bhthoma2/77GHx_phased_array/layout/testbenches/simulations/fmcw_fft_spectrum.csv

freq_kHz | power_dB
0.000000000000000000e+00 | -1.090621895206825229e+02
9.998999774820033215e-01 | -1.150786784525959945e+02
1.999799954964006643e+00 | -1.671857838909060945e+02
2.999699932446010298e+00 | -1.729609599861555580e+02
3.999599909928013286e+00 | -1.557259817246414002e+02
4.999499887410016719e+00 | -1.606970284841859780e+02
5.999399864892020595e+00 | -1.563933010316140724e+02
6.999299842374023584e+00 | -1.581940688958517853e+02
7.999199819856026572e+00 | -1.579772593100962013e+02
8.999099797338031337e+00 | -1.547865157363306139e+02
9.998999774820033437e+00 | -1.534639720176898265e+02
1.099889975230203731e+01 | -1.518139555042989741e+02
1.199879972978404119e+01 | -1.493432436280089064e+02
1.299869970726604329e+01 | -1.481261765680644089e+02
1.399859968474804717e+01 | -1.450455039046750301e+02
1.499849966223004927e+01 | -1.433179995515134237e+02
1.599839963971205314e+01 | -1.409208785659695309e+02
1.699829961719405702e+01 | -1.384513721816443876e+02
1.799819959467606267e+01 | -1.350676107547158153e+02
1.899809957215806122e+01 | -1.320419547814693146e+02
1.999799954964006687e+01 | -1.283672178343013286e+02
2.099789952712206897e+01 | -1.239795349886419871e+02
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
