bhthoma2/77GHx_phased_array/layout/testbenches/simulations/vibrometer_spectrum.csv

freq_Hz | mine_displacement_um | ground_displacement_um
0.000000000000000000e+00 | 2.290995417833598502e+00 | 5.967242599954593156e-03
1.562500000000000000e+01 | 2.011276875167306688e+00 | 5.195269922505948990e-03
3.125000000000000000e+01 | 7.555092282637777545e-01 | 1.956425115981483016e-03
4.687500000000000000e+01 | 8.818032765825689623e-02 | 2.256138587524450729e-04
6.250000000000000000e+01 | 2.040893415404172392e-02 | 3.436512302175389005e-05
7.812500000000000000e+01 | 4.964686714766459834e-03 | 2.022881577656870960e-05
9.375000000000000000e+01 | 1.550301483289384880e-03 | 2.336107414771621820e-05
1.093750000000000000e+02 | 9.700698680088382098e-03 | 1.860979419314093665e-05
1.250000000000000000e+02 | 6.060755942978538618e-02 | 1.206326097360342285e-05
1.406250000000000000e+02 | 3.664197379278069655e-01 | 1.532811229838642000e-05
1.562500000000000000e+02 | 4.178634805061605673e-01 | 8.616809125811206193e-06
1.718750000000000000e+02 | 1.088389716323305279e-01 | 1.098252997681459136e-05
1.875000000000000000e+02 | 1.221630721593647793e-02 | 1.028817932801487940e-05
2.031250000000000000e+02 | 3.546585447817903955e-03 | 8.686981510296186307e-06
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
