bhthoma2/77GHx_phased_array/layout/full_chip_layout.png

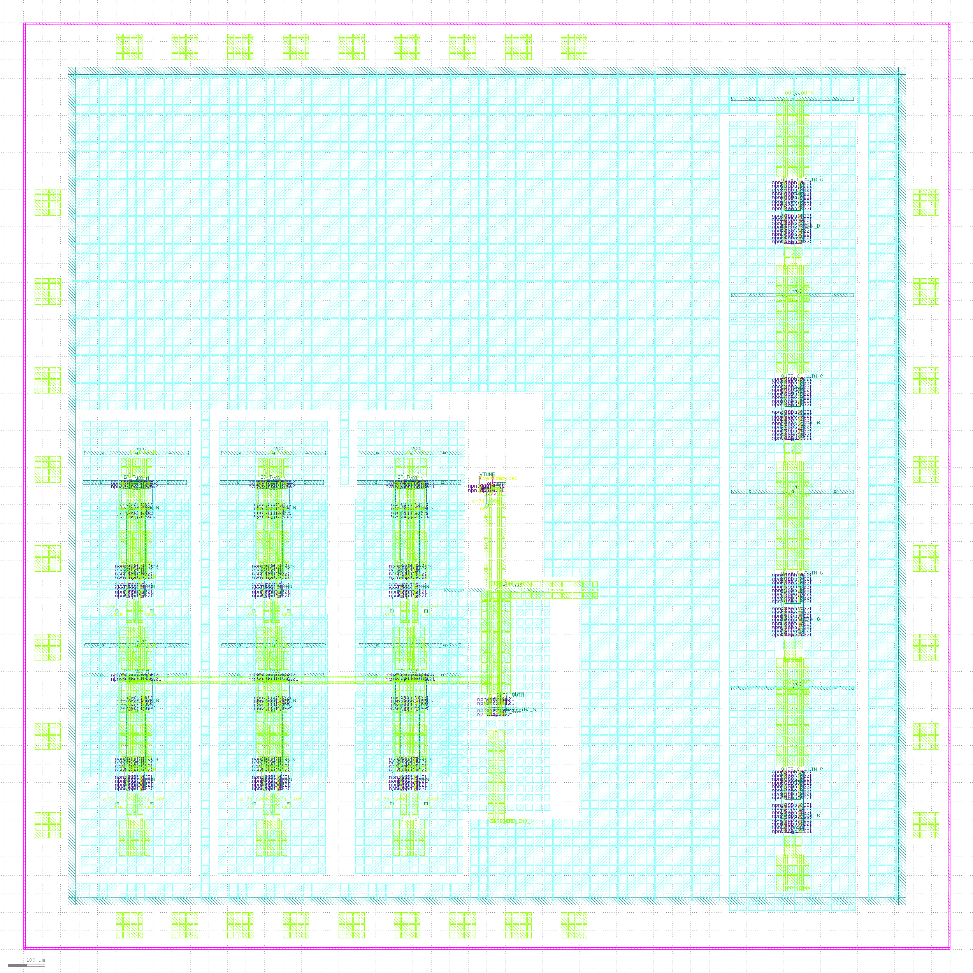
layout/full_chip_layout.png
