bhthoma2/77GHx_phased_array/sim/phase_shifter_results.txt

 7.00000000e+10  7.00000000e+10  0.00000000e+00  7.00000000e+10  1.26916296e-01  5.17553875e-02  7.00000000e+10  2.00000000e-01  0.00000000e+00  7.00000000e+10  6.34581480e-02  2.58776938e-02  7.00000000e+10 -6.34581480e-02 -2.58776938e-02  7.00000000e+10  1.00000000e-01  0.00000000e+00  7.00000000e+10 -1.00000000e-01  0.00000000e+00 
 7.01515152e+10  7.01515152e+10  0.00000000e+00  7.01515152e+10  1.26999486e-01  5.16685443e-02  7.01515152e+10  2.00000000e-01  0.00000000e+00  7.01515152e+10  6.34997432e-02  2.58342722e-02  7.01515152e+10 -6.34997432e-02 -2.58342722e-02  7.01515152e+10  1.00000000e-01  0.00000000e+00  7.01515152e+10 -1.00000000e-01  0.00000000e+00 
 7.03030303e+10  7.03030303e+10  0.00000000e+00  7.03030303e+10  1.27082234e-01  5.15818648e-02  7.03030303e+10  2.00000000e-01  0.00000000e+00  7.03030303e+10  6.35411172e-02  2.57909324e-02  7.03030303e+10 -6.35411172e-02 -2.57909324e-02  7.03030303e+10  1.00000000e-01  0.00000000e+00  7.03030303e+10 -1.00000000e-01  0.00000000e+00 
 7.04545455e+10  7.04545455e+10  0.00000000e+00  7.04545455e+10  1.27164543e-01  5.14953492e-02  7.04545455e+10  2.00000000e-01  0.00000000e+00  7.04545455e+10  6.35822713e-02  2.57476746e-02  7.04545455e+10 -6.35822713e-02 -2.57476746e-02  7.04545455e+10  1.00000000e-01  0.00000000e+00  7.04545455e+10 -1.00000000e-01  0.00000000e+00 
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
