bhthoma2/77GHx_phased_array/sim/radar_full_results.txt

 0.00000000e+00  2.79326692e+00  0.00000000e+00  2.78764656e+00  0.00000000e+00  2.05281450e+00 
 1.00000000e-12  2.79323010e+00  1.00000000e-12  2.78754390e+00  1.00000000e-12  2.05280015e+00 
 2.00000000e-12  2.79322576e+00  2.00000000e-12  2.78752316e+00  2.00000000e-12  2.05283011e+00 
 4.00000000e-12  2.79323541e+00  4.00000000e-12  2.78752886e+00  4.00000000e-12  2.05286235e+00 
 8.00000000e-12  2.79325845e+00  8.00000000e-12  2.78756814e+00  8.00000000e-12  2.05283804e+00 
 1.60000000e-11  2.79327409e+00  1.60000000e-11  2.78762384e+00  1.60000000e-11  2.05275629e+00 
 3.20000000e-11  2.79326382e+00  3.20000000e-11  2.78767782e+00  3.20000000e-11  2.05249357e+00 
 6.40000000e-11  2.79323356e+00  6.40000000e-11  2.78775361e+00  6.40000000e-11  2.05117444e+00 
 1.28000000e-10  2.79319006e+00  1.28000000e-10  2.78800207e+00  1.28000000e-10  2.04595673e+00 
 2.28000000e-10  2.79312429e+00  2.28000000e-10  2.78857185e+00  2.28000000e-10  2.03418369e+00 
 3.28000000e-10  2.79305505e+00  3.28000000e-10  2.78923513e+00  3.28000000e-10  2.02083150e+00 
 4.28000000e-10  2.79298396e+00  4.28000000e-10  2.78991575e+00  4.28000000e-10  2.00763906e+00 
 5.28000000e-10  2.79291164e+00  5.28000000e-10  2.79057853e+00  5.28000000e-10  1.99540210e+00 
 6.28000000e-10  2.79283819e+00  6.28000000e-10  2.79121013e+00  6.28000000e-10  1.98437811e+00 
 7.28000000e-10  2.79276368e+00  7.28000000e-10  2.79180729e+00  7.28000000e-10  1.97458071e+00 
 8.28000000e-10  2.79268818e+00  8.28000000e-10  2.79237063e+00  8.28000000e-10  1.96593629e+00 
 9.28000000e-10  2.79261173e+00  9.28000000e-10  2.79290185e+00  9.28000000e-10  1.95835161e+00 
 1.02800000e-09  2.79253438e+00  1.02800000e-09  2.79340274e+00  1.02800000e-09  1.95173707e+00 
 1.12800000e-09  2.79245620e+00  1.12800000e-09  2.79387492e+00  1.12800000e-09  1.94601186e+00 
 1.22800000e-09  2.79237723e+00  1.22800000e-09  2.79431986e+00  1.22800000e-09  1.94110331e+00 
 1.32800000e-09  2.79229751e+00  1.32800000e-09  2.79473892e+00  1.32800000e-09  1.93694527e+00 
 1.42800000e-09  2.79221710e+00  1.42800000e-09  2.79513339e+00  1.42800000e-09  1.93347677e+00 
 1.52800000e-09  2.79213603e+00  1.52800000e-09  2.79550450e+00  1.52800000e-09  1.93064125e+00 
 1.62800000e-09  2.79205435e+00  1.62800000e-09  2.79585344e+00  1.62800000e-09  1.92838608e+00 
 1.72800000e-09  2.79197210e+00  1.72800000e-09  2.79618135e+00  1.72800000e-09  1.92666221e+00 
 1.82800000e-09  2.79188932e+00  1.82800000e-09  2.79648933e+00  1.82800000e-09  1.92542398e+00 
 1.92800000e-09  2.79180605e+00  1.92800000e-09  2.79677844e+00  1.92800000e-09  1.92462887e+00 
 2.02800000e-09  2.79172231e+00  2.02800000e-09  2.79704968e+00  2.02800000e-09  1.92423737e+00 
 2.12800000e-09  2.79163815e+00  2.12800000e-09  2.79730402e+00  2.12800000e-09  1.92421272e+00 
 2.22800000e-09  2.79155359e+00  2.22800000e-09  2.79754236e+00  2.22800000e-09  1.92452082e+00 
 2.32800000e-09  2.79146867e+00  2.32800000e-09  2.79776558e+00  2.32800000e-09  1.92512998e+00 
 2.42800000e-09  2.79138341e+00  2.42800000e-09  2.79797451e+00  2.42800000e-09  1.92601081e+00 
 2.52800000e-09  2.79129784e+00  2.52800000e-09  2.79816994e+00  2.52800000e-09  1.92713607e+00 
 2.62800000e-09  2.79121198e+00  2.62800000e-09  2.79835261e+00  2.62800000e-09  1.92848051e+00 
 2.72800000e-09  2.79112586e+00  2.72800000e-09  2.79852323e+00  2.72800000e-09  1.93002074e+00 
 2.82800000e-09  2.79103951e+00  2.82800000e-09  2.79868247e+00  2.82800000e-09  1.93173514e+00 
 2.92800000e-09  2.79095295e+00  2.92800000e-09  2.79883096e+00  2.92800000e-09  1.93360369e+00 
 3.02800000e-09  2.79086619e+00  3.02800000e-09  2.79896930e+00  3.02800000e-09  1.93560792e+00 
 3.12800000e-09  2.79077925e+00  3.12800000e-09  2.79909806e+00  3.12800000e-09  1.93773075e+00 
 3.22800000e-09  2.79069216e+00  3.22800000e-09  2.79921777e+00  3.22800000e-09  1.93995644e+00 
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
