bhthoma2/77GHx_phased_array/sim/adc_results.txt

 0.00000000e+00  1.19999957e+00  0.00000000e+00  1.19999967e+00  0.00000000e+00  0.00000000e+00 
 1.00000000e-14  1.22732141e+00  1.00000000e-14  1.22732398e+00  1.00000000e-14  2.40000000e-04 
 1.01405029e-14  1.22770401e+00  1.01405029e-14  1.22770662e+00  1.01405029e-14  2.43372068e-04 
 1.04215086e-14  1.22846662e+00  1.04215086e-14  1.22846929e+00  1.04215086e-14  2.50116205e-04 
 1.09835200e-14  1.22997642e+00  1.09835200e-14  1.22997923e+00  1.09835200e-14  2.63604479e-04 
 1.21075428e-14  1.23293557e+00  1.21075428e-14  1.23293863e+00  1.21075428e-14  2.90581027e-04 
 1.43555884e-14  1.23862124e+00  1.43555884e-14  1.23862474e+00  1.43555884e-14  3.44534122e-04 
 1.88516797e-14  1.24914730e+00  1.88516797e-14  1.24915147e+00  1.88516797e-14  4.52440312e-04 
 2.70506679e-14  1.26583297e+00  2.70506679e-14  1.26583781e+00  2.70506679e-14  6.49216029e-04 
 3.69434607e-14  1.28224335e+00  3.69434607e-14  1.28224831e+00  3.69434607e-14  8.86643058e-04 
 4.85686003e-14  1.29720940e+00  4.85686003e-14  1.29721391e+00  4.85686003e-14  1.16564641e-03 
 6.07839639e-14  1.30884625e+00  6.07839639e-14  1.30884992e+00  6.07839639e-14  1.45881513e-03 
 7.41577597e-14  1.31780150e+00  7.41577597e-14  1.31780408e+00  7.41577597e-14  1.77978623e-03 
 8.98527424e-14  1.32448131e+00  8.98527424e-14  1.32448259e+00  8.98527424e-14  2.15646582e-03 
 1.14692327e-13  1.32934302e+00  1.14692327e-13  1.32934248e+00  1.14692327e-13  2.75261585e-03 
 1.47874427e-13  1.32941697e+00  1.47874427e-13  1.32941459e+00  1.47874427e-13  3.54898625e-03 
 1.83332738e-13  1.32563781e+00  1.83332738e-13  1.32563415e+00  1.83332738e-13  4.39998571e-03 
 2.36534840e-13  1.31764846e+00  2.36534840e-13  1.31764366e+00  2.36534840e-13  5.67683617e-03 
 3.01755650e-13  1.30728628e+00  3.01755650e-13  1.30728074e+00  3.01755650e-13  7.24213559e-03 
 3.75957376e-13  1.29652560e+00  3.75957376e-13  1.29651968e+00  3.75957376e-13  9.02297702e-03 
 4.46043036e-13  1.28792838e+00  4.46043036e-13  1.28792234e+00  4.46043036e-13  1.07050329e-02 
 5.16097966e-13  1.28089085e+00  5.16097966e-13  1.28088483e+00  5.16097966e-13  1.23863512e-02 
 5.94763469e-13  1.27443728e+00  5.94763469e-13  1.27443138e+00  5.94763469e-13  1.42743233e-02 
 6.92202435e-13  1.26772762e+00  6.92202435e-13  1.26772194e+00  6.92202435e-13  1.66128584e-02 
 7.91519538e-13  1.26162122e+00  7.91519538e-13  1.26161581e+00  7.91519538e-13  1.89964689e-02 
 8.99156784e-13  1.25542477e+00  8.99156784e-13  1.25541971e+00  8.99156784e-13  2.15797628e-02 
 9.86750972e-13  1.25067211e+00  9.86750972e-13  1.25066735e+00  9.86750972e-13  2.36820233e-02 
 1.06724441e-12  1.24657568e+00  1.06724441e-12  1.24657122e+00  1.06724441e-12  2.56138658e-02 
 1.22823128e-12  1.23928084e+00  1.22823128e-12  1.23927698e+00  1.22823128e-12  2.94775508e-02 
 1.49079803e-12  1.22998701e+00  1.49079803e-12  1.22998407e+00  1.49079803e-12  3.57791527e-02 
 1.80172426e-12  1.22268019e+00  1.80172426e-12  1.22267815e+00  1.80172426e-12  4.32413823e-02 
 2.13890553e-12  1.21819995e+00  2.13890553e-12  1.21819859e+00  2.13890553e-12  5.13337328e-02 
 2.47658547e-12  1.21617890e+00  2.47658547e-12  1.21617796e+00  2.47658547e-12  5.94380512e-02 
 3.13042571e-12  1.21618776e+00  3.13042571e-12  1.21618714e+00  3.13042571e-12  7.51302171e-02 
 3.96088630e-12  1.21987706e+00  3.96088630e-12  1.21987631e+00  3.96088630e-12  9.50612712e-02 
 4.96088630e-12  1.22589561e+00  4.96088630e-12  1.22589444e+00  4.96088630e-12  1.19061271e-01 
 5.96088630e-12  1.23202161e+00  5.96088630e-12  1.23201998e+00  5.96088630e-12  1.43061271e-01 
 6.96088630e-12  1.23782472e+00  6.96088630e-12  1.23782269e+00  6.96088630e-12  1.67061271e-01 
 7.96088630e-12  1.24327511e+00  7.96088630e-12  1.24327271e+00  7.96088630e-12  1.91061271e-01 
 8.96088630e-12  1.24842569e+00  8.96088630e-12  1.24842298e+00  8.96088630e-12  2.15061271e-01 
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
