bhthoma2/77GHx_phased_array/layout/testbenches/fullchip_lvs.spice

* Extracted by KLayout with SG13G2 LVS runset on : 24/07/2026 10:18

.SUBCKT PHASED_ARRAY_77G_XTOR G1 G1|G2 W W$1
Q$1 \$510 \$509 \$527 \$1 npn13G2l we=70n le=1000n Nx=1 m=8
Q$2 \$511 \$512 \$528 \$1 npn13G2l we=70n le=1000n Nx=1 m=8
Q$17 \$747 \$738 \$510 \$1 npn13G2l we=70n le=1000n Nx=1 m=8
Q$18 \$748 \$738 \$511 \$1 npn13G2l we=70n le=1000n Nx=1 m=8
Q$19 \$793 \$775 \$805 \$1 npn13G2l we=70n le=1000n Nx=1 m=4
Q$20 \$794 \$776 \$806 \$1 npn13G2l we=70n le=1000n Nx=1 m=4
Q$21 \$795 \$777 \$807 \$1 npn13G2l we=70n le=1000n Nx=1 m=4
Q$22 \$796 \$778 \$808 \$1 npn13G2l we=70n le=1000n Nx=1 m=4
Q$23 \$797 \$779 \$809 \$1 npn13G2l we=70n le=1000n Nx=1 m=4
Q$24 \$798 \$780 \$810 \$1 npn13G2l we=70n le=1000n Nx=1 m=4
Q$53 \$992 \$991 \$793 \$1 npn13G2l we=70n le=1000n Nx=1 m=4
Q$54 \$993 \$991 \$794 \$1 npn13G2l we=70n le=1000n Nx=1 m=4
Q$55 \$994 \$995 \$795 \$1 npn13G2l we=70n le=1000n Nx=1 m=4
Q$56 \$996 \$995 \$796 \$1 npn13G2l we=70n le=1000n Nx=1 m=4
Q$57 \$998 \$997 \$797 \$1 npn13G2l we=70n le=1000n Nx=1 m=4
Q$58 \$999 \$997 \$798 \$1 npn13G2l we=70n le=1000n Nx=1 m=4
Q$81 \$1415 \$1416 \$1417 \$1 npn13G2l we=70n le=1000n Nx=1 m=2
Q$83 \$1418 \$1419 \$1417 \$1 npn13G2l we=70n le=1000n Nx=1 m=2
Q$85 \$1438 \$1438 \$1459 \$1 npn13G2l we=70n le=1000n Nx=1 m=8
Q$87 \$1439 \$1439 \$1460 \$1 npn13G2l we=70n le=1000n Nx=1 m=8
Q$89 \$1440 \$1440 \$1461 \$1 npn13G2l we=70n le=1000n Nx=1 m=8
Q$97 \$1516 \$1516 \$1415 \$1 npn13G2l we=70n le=1000n Nx=1 m=2
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
C$530 \$2809 \$2808 cap_cmim w=6.99u l=6.99u A=48.8601p P=27.96u m=1
C$531 \$4799 \$4797 cap_cmim w=6.99u l=6.99u A=48.8601p P=27.96u m=1
C$532 G1 W G1|G2 \$1 sg13_hv_svaricap w=3.74u l=0.3u Nx=1
C$533 G1|G2 W$1 G1|G2 \$1 sg13_hv_svaricap w=3.74u l=0.3u Nx=1
.ENDS PHASED_ARRAY_77G_XTOR
