bhthoma2/77GHx_phased_array/layout/testbenches/simulations/sim_fmcw_system.spice

* ============================================================
* 77 GHz FMCW Radar — Full System Simulation with Chirp
* Baseband-equivalent model of TX/RX paths
*
* FMCW Parameters:
*   fc = 77 GHz, BW = 4 GHz, Tchirp = 1 ms
*   f_beat = 2*BW*R/(c*T) = 26.7 kHz/m
*   Target 1: R=3m → f_beat = 80 kHz
*   Target 2: R=7m → f_beat = 186.7 kHz (weaker, landmine)
*
* The mixer output is modeled as: cos(2π*f_beat*t)
* with amplitude set by radar equation path loss
* ============================================================

.param vcc_nom=3.3
.param tchirp=1m
.param bw=4e9
.param c_light=3e8

* Target parameters
.param r1=3
.param r2=7
.param rcs1=1
.param rcs2=0.01

* Beat frequencies
.param fb1={2*bw*r1/(c_light*tchirp)}
.param fb2={2*bw*r2/(c_light*tchirp)}

* RX signal amplitudes (from radar equation, post LNA+Mixer gain)
* Drone at 5m altitude, Pt=0dBm, Gt=Gr=10dBi, λ=3.9mm
* At R=3m, σ=1m²: After 41dB RF gain → 2.5mV differential
* At R=7m, σ=0.01m²: After 41dB RF gain → 25µV differential
.param v_beat1=2.5m
.param v_beat2=25u

* === SUPPLY ===
VCC vcc 0 DC {vcc_nom}

* === FMCW BEAT SIGNALS (baseband equivalent of TX→channel→RX→LNA→Mixer) ===
* Two targets produce two beat tones at the mixer IF output
B_if_p if_p 0 V = {v_beat1}*sin(6.283*{fb1}*time) + {v_beat2}*sin(6.283*{fb2}*time)
B_if_n if_n 0 V = -{v_beat1}*sin(6.283*{fb1}*time) - {v_beat2}*sin(6.283*{fb2}*time)

* === IF AMPLIFIER (40 dB, 10 MHz BW) ===
.subckt IFA inp inn outp outn
.param g=5 bw=10e6 vmax=0.5
B_p s1p 0 V = {vmax}*tanh({g}/{vmax}*V(inp,inn))
B_n s1n 0 V = -{vmax}*tanh({g}/{vmax}*V(inp,inn))
R1p s1p s1f 1
C1p s1f 0 {1/(6.283*{bw}*1.41)}
R1n s1n s1nf 1
C1n s1nf 0 {1/(6.283*{bw}*1.41)}
B_2p outp 0 V = {vmax}*tanh({g}/{vmax}*V(s1f,s1nf))
B_2n outn 0 V = -{vmax}*tanh({g}/{vmax}*V(s1f,s1nf))
R2p outp opf 1
C2p opf 0 {1/(6.283*{bw}*1.41)}
R2n outn onf 1
C2n onf 0 {1/(6.283*{bw}*1.41)}
.ends IFA

XIFA if_p if_n ifa_p ifa_n IFA

* === VGA (variable gain, VCTRL sets 0-30dB) ===
* Set gain for ADC full-scale: IFA out=0.93Vpp, ADC needs ±0.6V diff
.param vga_gain=0.55
B_vga_p vga_p 0 V = {vga_gain}*V(ifa_p,ifa_n)
B_vga_n vga_n 0 V = -{vga_gain}*V(ifa_p,ifa_n)
R_vgap vga_p vgapf 1
C_vgap vgapf 0 {1/(6.283*20e6)}
R_vgan vga_n vganf 1
C_vgan vganf 0 {1/(6.283*20e6)}

* === ADC (12-bit, 20 MSPS) ===
.param vref=1.2
B_adc dout 0 V = 3.3*min(1,max(0,(V(vga_p,vga_n)/{vref}+0.5)))
R_adc dout doutf 10
C_adc doutf 0 10p

* === POWER BUDGET (current sinks) ===
I_rf vcc 0 DC 156m

* === SIMULATION ===
* Run 2 chirp periods (2ms) with timestep for Nyquist of 10MHz
.tran 25n 2m

.control
run

* === MEASUREMENTS ===
let vif_diff = v(if_p) - v(if_n)
let vifa_diff = v(ifa_p) - v(ifa_n)
let vvga_diff = v(vga_p) - v(vga_n)

meas tran if_pp pp vif_diff from=1m to=2m
meas tran ifa_pp pp vifa_diff from=1m to=2m
meas tran vga_pp pp vvga_diff from=1m to=2m
meas tran adc_pp pp v(dout) from=1m to=2m
meas tran adc_avg avg v(dout) from=1m to=2m

* Measure beat frequencies via zero crossings
meas tran t1_rise1 when vif_diff=0 rise=10 from=1m
meas tran t1_rise2 when vif_diff=0 rise=11 from=1m
let period1 = t1_rise2 - t1_rise1
let fbeat1_meas = 1/period1

let g_ifa_db = 20 * log(ifa_pp / if_pp) / log(10)
let g_vga_db = 20 * log(vga_pp / ifa_pp) / log(10)
let g_total_db = 20 * log(vga_pp / if_pp) / log(10)
let pdc_mw = 156e-3 * 3.3 * 1000

echo ""
echo "════════════════════════════════════════════════════════════════"
echo "  77 GHz FMCW RADAR — FULL SYSTEM SIMULATION"
echo "════════════════════════════════════════════════════════════════"
echo ""
echo "  FMCW Chirp: BW=4GHz, Tchirp=1ms, fc=77GHz"
echo ""
echo "  ┌─────────────────────────────────────────────────────────┐"
echo "  │ TARGET     │ Range │ RCS    │ f_beat    │ IF Amplitude  │"
echo "  ├────────────┼───────┼────────┼───────────┼───────────────┤"
echo "  │ Ground     │  3 m  │ 1 m²   │  80 kHz  │ 2.5 mV       │"
echo "  │ Landmine   │  7 m  │ 0.01m² │ 187 kHz  │ 25 uV        │"
echo "  └─────────────────────────────────────────────────────────┘"
echo ""
echo "  --- Signal Chain Levels ---"
echo "  IF input (post-LNA+Mixer):  $&if_pp Vpp diff"
echo "  IFA output (40dB gain):     $&ifa_pp Vpp diff"
echo "  VGA output (23dB gain):     $&vga_pp Vpp diff"
echo "  ADC output:                 $&adc_pp Vpp (0-3.3V)"
echo "  ADC DC level:               $&adc_avg V (mid=1.65V)"
echo ""
echo "  --- Gain Budget ---"
echo "  IFA gain:    $&g_ifa_db dB"
echo "  VGA gain:    $&g_vga_db dB"
echo "  Total BB:    $&g_total_db dB"
echo ""
echo "  --- Beat Frequency ---"
echo "  Measured f_beat: $&fbeat1_meas Hz"
echo "  Expected (3m):   80000 Hz"
echo ""
echo "  --- Radar Performance ---"
echo "  Range resolution:     3.75 cm"
echo "  Velocity resolution:  1.95 mm/s"
echo "  Vibration sensitivity: <1 µm (phase)"
echo "  Max range (ADC BW):   37.5 m"
echo ""
echo "  --- Power ---"
echo "  Total PDC:   $&pdc_mw mW"
echo "════════════════════════════════════════════════════════════════"

* Write output for FFT analysis
wrdata /home/bthomas3/Videos/77GHz_phased_array/layout/testbenches/simulations/fmcw_adc_output.dat v(dout)

quit
.endc
.end
