bhthoma2/77GHx_phased_array/tb/tb_phased_array_landmine.v

`timescale 1ns/1ps
//============================================================================
// INTEGRATED MIXED-SIGNAL TESTBENCH: 6x6 Phased Array Landmine Detection
// 77GHz FMCW Vibrometer - IHP SG13G2 130nm SiGe BiCMOS
//
// Architecture:
//   TX: VCO -> 6x (Phase Shifter + PA) -> 6 TX antennas (beam steering)
//   RX: 6 RX antennas -> 6x (LNA + Mixer + IFA + VGA + ADC + DIGIF)
//   Digital: vibrometer_top (Range FFT + Beamforming + Slow-Time FFT + SPI)
//
// Analog gains (SPICE-calibrated, IHP SG13G2 PDK):
//   LNA: 15.4 dB | Mixer: 15.8 dB CG | IFA: 44 dB | VGA: 11 dB
//   Total RX chain: 56.8 dB | ADC: 12-bit, 100 MSPS
//   TX PA: 0 dBm per element, 7.8 dBm array (6 elements coherent)
//
// Scenario: Buried AP landmine at 5m, 1um vibration @ 200Hz
//   TX steers beam to broadside, RX digitally beamforms
//   Micro-Doppler extracted via 128-pt slow-time FFT
//============================================================================

module tb_phased_array_landmine;

parameter DW       = 16;
parameter N_FFT    = 64;
parameter N_CH     = 6;
parameter N_CHIRPS = 128;
parameter N_BEAMS  = 4;
parameter SRAM_AW  = 10;
parameter SRAM_DW  = 32;
parameter N_ELEM   = 6;

// Physics
parameter real PI         = 3.14159265358979;
parameter real C_LIGHT    = 3.0e8;
parameter real F_C        = 77.0e9;
parameter real LAMBDA     = C_LIGHT / F_C;       // 3.9 mm
parameter real D_ELEM     = LAMBDA / 2.0;        // Element spacing (1.95 mm)
parameter real BW         = 70.0e6;
parameter real T_CHIRP    = 1.0e-6;
parameter real CHIRP_SLOPE = BW / T_CHIRP;
parameter real F_ADC      = 100.0e6;
parameter real T_SAMPLE   = 1.0 / F_ADC;

// Target
parameter real TARGET_RANGE    = 5.0;
parameter real TARGET_ANGLE    = 0.0;            // Broadside (radians)
parameter real VIB_AMPLITUDE   = 1.0e-6;         // 1 um
parameter real VIB_FREQ        = 200.0;          // Hz

// Derived
parameter real BEAT_FREQ  = CHIRP_SLOPE * 2.0 * TARGET_RANGE / C_LIGHT;
parameter real PHASE_MOD  = 4.0 * PI * F_C * VIB_AMPLITUDE / C_LIGHT;

// Analog chain (SPICE-calibrated)
parameter real G_CHAIN    = 695.0;               // 56.8 dB total RX gain
parameter real V_NOISE_RMS = 1.0e-4;
parameter real V_FS       = 1.2;
parameter integer N_BITS  = 12;
parameter real V_LSB      = V_FS / (2**N_BITS);

// TX array
parameter real TX_POWER_PER_ELEM = 1.0e-3;      // 0 dBm per PA


// Clutter
parameter real CLUTTER_AMP = 10.0;

// TX-RX isolation (on-chip leakage): 10^(-40/20) = 0.01
parameter real TX_RX_COUPLING = 0.01;
// Mutual coupling between adjacent RX elements: 10^(-20/20) = 0.1
parameter real MUTUAL_COUPLING = 0.1;

// Clock
reg clk;
reg rst_n;
always #2.5 clk = ~clk;

// DUT
reg  chirp_start;
reg  signed [DW-1:0] adc_data [0:N_CH-1];
reg  adc_valid;
reg  [3:0] beam_idx;
reg  [5:0] target_range_bin;
reg  [7:0] excite_doppler_bin;
reg  process_start;
wire spi_clk_o, spi_mosi_o, spi_cs_n_o;
wire busy;

vibrometer_top #(
    .DW(DW), .N_FFT(N_FFT), .N_CH(N_CH),
    .N_CHIRPS(N_CHIRPS), .N_BEAMS(N_BEAMS),
    .SRAM_AW(SRAM_AW), .SRAM_DW(SRAM_DW)
) u_vibrometer (
    .clk(clk),
    .rst_n(rst_n),
    .chirp_start(chirp_start),
    .adc_data_0(adc_data[0]),
    .adc_data_1(adc_data[1]),
    .adc_data_2(adc_data[2]),
    .adc_data_3(adc_data[3]),
    .adc_data_4(adc_data[4]),
    .adc_data_5(adc_data[5]),
    .adc_valid(adc_valid),
    .beam_idx(beam_idx),
    .target_range_bin(target_range_bin),
    .excite_doppler_bin(excite_doppler_bin),
    .process_start(process_start),
    .spi_clk_o(spi_clk_o),
    .spi_mosi_o(spi_mosi_o),
    .spi_cs_n_o(spi_cs_n_o),
    .busy(busy)
);

// State
real t_global;
real chirp_prf;
integer chirp_i, sample_i, beam_i, ch_i;
integer errors;
integer seed;

// TX beamforming state
real tx_steering_angle;        // Current TX beam angle (rad)
real tx_phase_shift [0:N_ELEM-1]; // Per-element TX phase (used for display)
real tx_array_factor;          // TX array gain toward target

// RX signal model
real rx_signal_per_elem;
real beat_phase;
real doppler_phase;
real array_phase;
real total_voltage;
real noise_sample;
real clutter_sample;

// Noise generator
function real gaussian_noise;
    input integer s;
    real u1, u2;
begin
    u1 = $itor($random(s) % 10000 + 10000) / 20000.0;
    u2 = $itor($random(s) % 10000 + 10000) / 20000.0;
    if (u1 < 0.0001) u1 = 0.0001;
    gaussian_noise = $sqrt(-2.0 * $ln(u1)) * $cos(2.0 * PI * u2);
end
endfunction

// ADC model
function signed [DW-1:0] adc_quantize;
    input real vin;
    real clipped;
    integer code;
begin
    clipped = vin;
    if (clipped > V_FS/2.0)  clipped = V_FS/2.0 - V_LSB;
    if (clipped < -V_FS/2.0) clipped = -V_FS/2.0;
    code = $rtoi(clipped / V_LSB);
    if (code > 2047)  code = 2047;
    if (code < -2048) code = -2048;
    adc_quantize = $signed(code[DW-1:0]);
end
endfunction

//============================================================================
// MAIN STIMULUS
//============================================================================
initial begin
    seed = 12345;
    errors = 0;
    chirp_prf = T_CHIRP * 2.0;

    // TX beam steering: point at target (broadside = 0)
    tx_steering_angle = TARGET_ANGLE;
    begin : compute_tx_phase
        integer ei;
        for (ei = 0; ei < N_ELEM; ei = ei + 1) begin
            tx_phase_shift[ei] = 2.0 * PI * $itor(ei) * D_ELEM *
                                 $sin(tx_steering_angle) / LAMBDA;
        end
    end

    // TX array factor toward target
    // AF = |sum(exp(j*(tx_phase - target_phase)))| / N
    // For broadside steering toward broadside target: AF = 1.0 (max)
    tx_array_factor = 1.0; // All elements coherent toward target

    // RF signal at each RX antenna element
    // Full radar equation: P_rx = P_tx*G_tx*G_rx*lambda^2*RCS / (4*pi)^3 / R^4
    // Numerically: sqrt(6*1e-3*50) * (3.9e-3)^2 * 0.01 / (64*pi^3*5^4) ~ 6.7e-14 V
    // This is correct physically but too small for fixed-point arithmetic.
    // Use boosted value for functional verification (10x link margin assumed)
    // Real: 0.67uV; Boosted: 6.7uV → 4.66mV at ADC → ~16 LSBs (well above noise)
    rx_signal_per_elem = 6.7e-6;

    $display("");
    $display("╔════════════════════════════════════════════════════════════════════╗");
    $display("║  6x6 PHASED ARRAY LANDMINE DETECTION - MIXED-SIGNAL SIMULATION   ║");
    $display("║  77GHz FMCW Vibrometer | IHP SG13G2 130nm SiGe BiCMOS            ║");
    $display("╠════════════════════════════════════════════════════════════════════╣");
    $display("║  TX ARRAY (analog beamforming):                                   ║");
    $display("║    6 elements, lambda/2 spacing (1.95mm), per-element phase ctrl  ║");
    $display("║    Phase Shifter: varactor-loaded diff pair (npn13G2l)            ║");
    $display("║    PA: CE push-pull, 0 dBm/element, 7.8 dBm EIRP (coherent)      ║");
    $display("║    Beam steering: VCTRL_PS0..5 (analog voltage control)           ║");
    $display("║    Current steering angle: %.1f deg (broadside)",
             tx_steering_angle * 180.0 / PI);
    $display("║                                                                   ║");
    $display("║  RX ARRAY (digital beamforming):                                  ║");
    $display("║    6 elements, lambda/2 spacing, independent RX chains            ║");
    $display("║    LNA(15.4dB) -> Mixer(15.8dB) -> IFA(44dB) -> VGA(11dB)         ║");
    $display("║    -> 12-bit ADC (100MSPS) -> DIGIF CML                           ║");
    $display("║    Digital beamforming in Range FFT MAC engine (4 beams)           ║");
    $display("║                                                                   ║");
    $display("║  DIGITAL BACKEND:                                                 ║");
    $display("║    Range FFT (64-pt, 6-ch) -> Slow-Time FFT (128-pt)              ║");
    $display("║    -> Vibration extraction -> SPI output                           ║");
    $display("╠════════════════════════════════════════════════════════════════════╣");
    $display("║  TARGET: AP mine, 5m range, 0 deg, 1um vib @ 200Hz               ║");
    $display("║  Beat freq: %.2f MHz | Phase mod: %.2f mrad",
             BEAT_FREQ/1e6, PHASE_MOD*1e3);
    $display("║  RX signal/element: %.2f uV -> %.3f mV at ADC",
             rx_signal_per_elem*1e6, rx_signal_per_elem*G_CHAIN*1e3);
    $display("╚════════════════════════════════════════════════════════════════════╝");
    $display("");

    clk = 0; rst_n = 0;
    chirp_start = 0; adc_valid = 0; process_start = 0;
    beam_idx = 0;
    target_range_bin = $rtoi(BEAT_FREQ / (F_ADC / $itor(N_FFT)));
    excite_doppler_bin = 8'd0;
    for (ch_i = 0; ch_i < N_CH; ch_i = ch_i + 1)
        adc_data[ch_i] = 0;

    #50 rst_n = 1;
    #20;

    $display("[%0t] Acquisition: %0d chirps x %0d beams x %0d samples x %0d channels",
             $time, N_CHIRPS, N_BEAMS, N_FFT, N_CH);

    //=== ACQUISITION ===
    for (chirp_i = 0; chirp_i < N_CHIRPS; chirp_i = chirp_i + 1) begin
        for (beam_i = 0; beam_i < N_BEAMS; beam_i = beam_i + 1) begin

            @(posedge clk);
            chirp_start = 1;
            beam_idx = beam_i[3:0];
            @(posedge clk);
            chirp_start = 0;

            for (sample_i = 0; sample_i < N_FFT; sample_i = sample_i + 1) begin
                @(posedge clk);

                t_global = $itor(chirp_i * N_BEAMS + beam_i) * chirp_prf
                           + $itor(sample_i) * T_SAMPLE;

                for (ch_i = 0; ch_i < N_CH; ch_i = ch_i + 1) begin
                    // Beat signal phase
                    beat_phase = 2.0 * PI * BEAT_FREQ * ($itor(sample_i) * T_SAMPLE);

                    // Micro-Doppler phase modulation
                    doppler_phase = PHASE_MOD * $sin(2.0 * PI * VIB_FREQ * t_global);

                    // RX array phase (element-dependent for target at angle)
                    // For broadside target: all elements receive in-phase
                    array_phase = 2.0 * PI * $itor(ch_i) * D_ELEM *
                                  $sin(TARGET_ANGLE) / LAMBDA;

                    if (beam_i == 0) begin
                        // Target in beam 0
                        total_voltage = rx_signal_per_elem * G_CHAIN *
                            tx_array_factor *
                            $cos(beat_phase + doppler_phase + array_phase);

                        // Thermal noise
                        noise_sample = V_NOISE_RMS * gaussian_noise(seed);
                        seed = seed + 1;
                        total_voltage = total_voltage + noise_sample;

                        // Ground clutter (different range bin)
                        clutter_sample = V_NOISE_RMS * CLUTTER_AMP *
                            $cos(2.0*PI*0.93e6*($itor(sample_i)*T_SAMPLE) +
                                 $itor(ch_i)*0.5);
                        total_voltage = total_voltage + clutter_sample;
                    end else begin
                        noise_sample = V_NOISE_RMS * gaussian_noise(seed);
                        seed = seed + 1;
                        clutter_sample = V_NOISE_RMS * CLUTTER_AMP *
                            $cos(2.0*PI*0.93e6*($itor(sample_i)*T_SAMPLE) +
                                 $itor(ch_i)*0.5 + $itor(beam_i)*1.2);
                        total_voltage = noise_sample + clutter_sample;
                    end

                    // TX-RX on-chip leakage (DC after self-mixing, filtered by HPF in IFA)
                    // Residual after HPF: ~1% of leaked signal
                    total_voltage = total_voltage + TX_RX_COUPLING * 0.01 * V_FS * 0.5;

                    // Adjacent element mutual coupling (adds correlated noise)
                    if (ch_i > 0)
                        total_voltage = total_voltage + MUTUAL_COUPLING * V_NOISE_RMS *
                            $cos(beat_phase + array_phase - 2.0*PI*D_ELEM*$sin(TARGET_ANGLE)/LAMBDA);

                    adc_data[ch_i] = adc_quantize(total_voltage);
                end

                @(posedge clk);
                adc_valid = 1;
                @(posedge clk);
                adc_valid = 0;
            end

            wait(busy == 0);
            #10;
        end

        if (chirp_i % 32 == 0)
            $display("[%0t] Chirp %0d/%0d", $time, chirp_i, N_CHIRPS);
    end

    $display("");
    $display("[%0t] Acquisition complete. Waiting for pipeline drain...", $time);
    wait(busy == 0);
    #50;
    wait(busy == 0);

    @(posedge clk);
    process_start = 1;
    @(posedge clk);
    process_start = 0;

    // Wait for SPI
    fork
        begin wait(spi_cs_n_o == 0); end
        begin #5000000; errors = errors + 1; end
    join_any
    disable fork;

    if (spi_cs_n_o == 0) begin : capture
        reg [37:0] frame;
        integer bit_i;
        reg signed [15:0] result_re, result_im;
        real magnitude;

        frame = 0;
        bit_i = 37;
        while (spi_cs_n_o == 0 && bit_i >= 0) begin
            @(posedge spi_clk_o);
            frame[bit_i] = spi_mosi_o;
            bit_i = bit_i - 1;
        end

        result_re = $signed(frame[31:16]);
        result_im = $signed(frame[15:0]);
        magnitude = $sqrt($itor(result_re)*$itor(result_re) +
                          $itor(result_im)*$itor(result_im));

        $display("");
        $display("╔════════════════════════════════════════════════════════════════════╗");
        $display("║                    DETECTION RESULTS                              ║");
        $display("╠════════════════════════════════════════════════════════════════════╣");
        $display("║  SPI Frame: 0x%010h", frame);
        $display("║  Range bin: %0d | RE: %0d | IM: %0d | Mag: %.1f",
                 frame[37:32], result_re, result_im, magnitude);
        $display("╠════════════════════════════════════════════════════════════════════╣");

        if (magnitude > 0) begin
            $display("║  *** LANDMINE DETECTED ***                                       ║");
            $display("║                                                                   ║");
            $display("║  End-to-end signal path:                                          ║");
            $display("║    VCO (77GHz) -> 6x Phase Shifter -> 6x PA -> TX antennas        ║");
            $display("║    -> Target (5m, vibrating) -> 6x RX antennas                    ║");
            $display("║    -> 6x (LNA -> Mixer -> IFA -> VGA -> ADC -> DIGIF)             ║");
            $display("║    -> Digital Beamformer (4 beams) -> Range FFT                    ║");
            $display("║    -> Slow-Time FFT (128-pt) -> Vibration Extraction              ║");
            $display("║    -> SPI Output to Drone Flight Controller                       ║");
            $display("║                                                                   ║");
            $display("║  PASS: Vibration signature extracted from 6x6 phased array        ║");
        end else begin
            $display("║  *** NO DETECTION ***                                             ║");
            $display("║  FAIL: Signal below threshold                                     ║");
            errors = errors + 1;
        end
        $display("╚════════════════════════════════════════════════════════════════════╝");
    end

    $display("");
    if (errors == 0)
        $display("SIMULATION PASSED");
    else
        $display("SIMULATION FAILED: %0d errors", errors);
    #100;
    $finish;
end

initial begin
    #200000000;
    $display("TIMEOUT");
    $finish;
end

initial begin
    $dumpfile("tb_phased_array_landmine.vcd");
    $dumpvars(0, tb_phased_array_landmine);
end

endmodule
