bhthoma2/77GHx_phased_array/tb/tb_landmine_detect.v

`timescale 1ns/1ps
//============================================================================
// INTEGRATED MIXED-SIGNAL TESTBENCH: Landmine Vibration Detection
// 77GHz FMCW Phased Array Vibrometer
// IHP SG13G2 130nm SiGe BiCMOS
//
// Architecture:
//   ANALOG FRONT-END (calibrated from transistor-level SPICE):
//     Antenna -> LNA (15dB) -> Mixer (6dB) -> IFA (44dB) -> VGA (20dB)
//     -> 12-bit SAR ADC (100MSPS) -> DIGIF CML (200mV swing)
//     Gains validated: radar_mixed_signal_tb.spice (IHP SG13G2 PDK)
//
//   DIGITAL BACKEND (RTL):
//     vibrometer_top: Range FFT -> Slow-Time FFT -> SPI serializer
//
// Scenario:
//   - Acoustic excitation at 200Hz couples into buried landmine
//   - Mine casing resonates with 1um displacement amplitude
//   - FMCW radar (77GHz, 70MHz BW, 1us chirp) detects micro-Doppler
//   - 4-beam phased array provides angular resolution
//   - Target at 5m range -> beat freq = 2.33 MHz
//   - Phase modulation: dphi = 4*pi*f_c*vib/c = 3.23 mrad peak
//
// Pass criteria:
//   - SPI output contains non-zero vibration amplitude
//   - Detected beam index matches stimulated beam
//   - SNR > 0 dB in target Doppler bin
//============================================================================

module tb_landmine_detect;

// System parameters
parameter DW       = 16;

parameter N_FFT    = 64;
parameter N_CH     = 6;
parameter N_CHIRPS = 128;
parameter N_BEAMS  = 4;
parameter SRAM_AW  = 10;
parameter SRAM_DW  = 32;

// FMCW radar parameters
parameter real F_C         = 77.0e9;      // Carrier frequency (Hz)
parameter real BW          = 70.0e6;      // Chirp bandwidth (Hz)
parameter real T_CHIRP     = 1.0e-6;      // Chirp duration (s)
parameter real CHIRP_SLOPE = BW/T_CHIRP;  // 70 THz/s
parameter real C_LIGHT     = 3.0e8;       // Speed of light (m/s)
parameter real F_ADC       = 100.0e6;     // ADC sample rate (Hz)
parameter real T_SAMPLE    = 1.0/F_ADC;   // 10 ns sample period

// Target parameters (buried AP landmine)
parameter real TARGET_RANGE   = 5.0;      // Range to target (m)
parameter real VIB_AMPLITUDE  = 1.0e-6;   // Vibration displacement (1 um)
parameter real VIB_FREQ       = 200.0;    // Vibration frequency (Hz)


// Derived radar parameters
parameter real BEAT_FREQ   = CHIRP_SLOPE * 2.0*TARGET_RANGE/C_LIGHT; // 2.33 MHz
parameter real RANGE_BIN   = BEAT_FREQ / (F_ADC/N_FFT);              // ~1.49 -> bin 1-2
parameter real PHASE_MOD   = 4.0*3.14159*F_C*VIB_AMPLITUDE/C_LIGHT;  // 3.23 mrad

// Analog chain gains (from SPICE simulation: radar_mixed_signal_tb.spice)
// Measured with IHP SG13G2 PDK transistor models:
//   LNA: 5.86mV out / 1mV in = 5.86x (15.4 dB)
//   Mixer: 36.4mV / 5.86mV = 6.2x (15.8 dB conversion gain from RF)
//   IFA: 195mV / 36.4mV = 5.36x per stage (14.6 dB per stage, 44 dB total)
//   VGA: 695mV / 195mV = 3.56x (11.0 dB at Vctrl=0.95V)
//   Total: 695x (56.8 dB) from LNA input to VGA output
parameter real G_LNA  = 5.86;
parameter real G_MIX  = 6.21;
parameter real G_IFA  = 5.36;   // Per stage (2 stages)
parameter real G_VGA  = 3.56;
parameter real G_CHAIN = G_LNA * G_MIX * G_IFA * G_IFA * G_VGA; // = 695x

// ADC parameters (from SPICE: ADC_SAR_12B StrongARM comparator)
parameter real V_FS    = 1.2;         // Full-scale voltage
parameter integer N_BITS = 12;
parameter real V_LSB   = V_FS / (2**N_BITS);

// Noise parameters
parameter real V_NOISE_RMS = 1.0e-4; // ~100uV rms at VGA output (from sim)

// Clutter parameters (ground return, 20dB above noise)
parameter real CLUTTER_AMP = 10.0;   // Clutter amplitude relative to noise

// Clock
reg clk;
reg rst_n;
always #2.5 clk = ~clk; // 200 MHz digital clock

// DUT interface
reg  chirp_start;
reg  signed [DW-1:0] adc_data [0:N_CH-1];
reg  adc_valid;
reg  [3:0] beam_idx;
reg  [5:0] target_range_bin;
reg  [7:0] excite_doppler_bin;
reg  process_start;
wire spi_clk_o, spi_mosi_o, spi_cs_n_o;
wire busy;

// DUT instantiation
vibrometer_top #(
    .DW(DW), .N_FFT(N_FFT), .N_CH(N_CH),
    .N_CHIRPS(N_CHIRPS), .N_BEAMS(N_BEAMS),
    .SRAM_AW(SRAM_AW), .SRAM_DW(SRAM_DW)
) u_vibrometer (
    .clk(clk),
    .rst_n(rst_n),
    .chirp_start(chirp_start),
    .adc_data_0(adc_data[0]),
    .adc_data_1(adc_data[1]),
    .adc_data_2(adc_data[2]),
    .adc_data_3(adc_data[3]),
    .adc_data_4(adc_data[4]),
    .adc_data_5(adc_data[5]),
    .adc_valid(adc_valid),
    .beam_idx(beam_idx),
    .target_range_bin(target_range_bin),
    .excite_doppler_bin(excite_doppler_bin),
    .process_start(process_start),
    .spi_clk_o(spi_clk_o),
    .spi_mosi_o(spi_mosi_o),
    .spi_cs_n_o(spi_cs_n_o),
    .busy(busy)
);

// Simulation state
real pi;
real t_global;           // Global time for Doppler phase evolution
real chirp_prf;          // Chirp repetition interval
integer chirp_i, sample_i, beam_i, ch_i;
integer errors;
integer seed;

// Analog model intermediates
real rf_power_w;         // Received RF power (W)
real rf_voltage;         // RF voltage at antenna (V)
real beat_phase;         // Beat signal phase
real doppler_phase;      // Micro-Doppler phase modulation
real signal_at_adc;      // Signal voltage at ADC input
real noise_sample;       // Noise contribution
real clutter_sample;     // Ground clutter
real total_voltage;      // Total voltage at ADC

real snr_estimate;       // Estimated SNR

//============================================================================
// ANALOG FRONT-END MODEL
// Calibrated from transistor-level SPICE (IHP SG13G2 PDK)
// Models: signal path, thermal noise, ground clutter, ADC quantization
//============================================================================

function real gaussian_noise;
    input integer s;
    real u1, u2, g;
begin
    u1 = $itor($random(s) % 10000 + 10000) / 20000.0;
    u2 = $itor($random(s) % 10000 + 10000) / 20000.0;
    if (u1 < 0.0001) u1 = 0.0001;
    g = $sqrt(-2.0 * $ln(u1)) * $cos(2.0 * 3.14159265 * u2);
    gaussian_noise = g;
end
endfunction

function signed [DW-1:0] analog_to_digital;
    input real vin;
    real clipped;
    integer code;
begin
    clipped = vin;
    if (clipped > V_FS/2.0)  clipped = V_FS/2.0 - V_LSB;
    if (clipped < -V_FS/2.0) clipped = -V_FS/2.0;
    code = $rtoi(clipped / V_LSB);
    if (code > 2047)  code = 2047;
    if (code < -2048) code = -2048;
    analog_to_digital = $signed(code[DW-1:0]);
end
endfunction

//============================================================================
// MAIN STIMULUS: LANDMINE DETECTION SCENARIO
//============================================================================
initial begin
    pi = 3.14159265358979;
    seed = 42;
    errors = 0;
    chirp_prf = T_CHIRP * 2.0; // 2us PRI (50% duty cycle)

    // RF signal level at antenna (from radar range equation)
    // Pt=10dBm, Gt=10dBi, lambda=3.9mm, R=5m, RCS=-20dBm2
    // Pr = Pt*Gt^2*lambda^2*RCS / (4*pi)^3 / R^4
    // = 10mW * 100 * (3.9e-3)^2 * 0.01 / 1984 / 625 = ~1.23e-11 W
    rf_power_w = 1.23e-11;
    rf_voltage = $sqrt(rf_power_w * 50.0); // ~0.78 uV into 50 ohm

    // Expected signal at ADC after full chain gain
    signal_at_adc = rf_voltage * G_CHAIN; // ~0.54 mV
    snr_estimate = 20.0 * $ln(signal_at_adc / V_NOISE_RMS) / $ln(10.0);

    $display("");
    $display("╔══════════════════════════════════════════════════════════════╗");
    $display("║  LANDMINE VIBRATION DETECTION - MIXED-SIGNAL SIMULATION    ║");
    $display("║  77GHz FMCW Phased Array Vibrometer                        ║");
    $display("║  IHP SG13G2 130nm SiGe BiCMOS                              ║");
    $display("╠══════════════════════════════════════════════════════════════╣");
    $display("║  SCENARIO: AP mine buried 10cm, acoustic excite @ 200Hz    ║");
    $display("║  Drone altitude: 5m, vibration amplitude: 1 um             ║");
    $display("╠══════════════════════════════════════════════════════════════╣");
    $display("║  RADAR PARAMETERS:                                         ║");
    $display("║    Carrier:     77 GHz                                     ║");
    $display("║    Bandwidth:   70 MHz (range res = 2.14 m)                ║");
    $display("║    Chirp:       1 us, PRF = 500 kHz                        ║");
    $display("║    ADC:         12-bit, 100 MSPS                           ║");
    $display("║    Beams:       4 (6-element ULA, lambda/2 spacing)        ║");
    $display("╠══════════════════════════════════════════════════════════════╣");
    $display("║  ANALOG CHAIN (SPICE-calibrated, IHP SG13G2 PDK):          ║");
    $display("║    LNA:   15.4 dB gain, NF=5 dB (npn13G2l cascode)        ║");
    $display("║    Mixer: 15.8 dB CG (Gilbert cell, npn13G2l)             ║");
    $display("║    IFA:   44 dB (2-stage diff pair, npn13G2l)              ║");
    $display("║    VGA:   11 dB @ Vctrl=0.95V (variable-gm)               ║");
    $display("║    ADC:   12-bit StrongARM (sg13_lv_nmos/pmos)             ║");
    $display("║    DIGIF: CML buffer, 200mV swing, 50 ohm                 ║");
    $display("║    Total chain gain: 56.8 dB                               ║");
    $display("╠══════════════════════════════════════════════════════════════╣");
    $display("║  SIGNAL BUDGET:                                            ║");
    $display("║    RF at antenna:    %.2f uV (%.1f dBm)", rf_voltage*1e6,
             10.0*$ln(rf_power_w/1e-3)/$ln(10.0));
    $display("║    Signal at ADC:    %.3f mV", signal_at_adc*1e3);
    $display("║    Noise at ADC:     %.3f mV rms", V_NOISE_RMS*1e3);
    $display("║    Pre-FFT SNR:      %.1f dB", snr_estimate);
    $display("║    FFT gain:         %.1f dB (N=%0d)", 
             10.0*$ln(1.0*N_FFT)/$ln(10.0), N_FFT);
    $display("║    Post-FFT SNR:     %.1f dB", 
             snr_estimate + 10.0*$ln(1.0*N_FFT)/$ln(10.0));
    $display("║    Beat frequency:   %.2f MHz (range bin ~%0d)",
             BEAT_FREQ/1e6, $rtoi(RANGE_BIN));
    $display("║    Phase modulation: %.2f mrad peak", PHASE_MOD*1e3);
    $display("╚══════════════════════════════════════════════════════════════╝");
    $display("");

    // Initialize
    clk = 0; rst_n = 0;
    chirp_start = 0; adc_valid = 0; process_start = 0;
    beam_idx = 0;
    target_range_bin = $rtoi(RANGE_BIN);
    excite_doppler_bin = 8'd5; // Doppler bin for 200Hz at PRF/N_CHIRPS
    for (ch_i = 0; ch_i < N_CH; ch_i = ch_i + 1)
        adc_data[ch_i] = 0;

    // Reset
    #50 rst_n = 1;
    #20;

    $display("[%0t] Starting acquisition: %0d chirps x %0d beams x %0d samples",
             $time, N_CHIRPS, N_BEAMS, N_FFT);
    $display("[%0t] Expected duration: %0d clock cycles",
             $time, N_CHIRPS * N_BEAMS * (N_FFT * 4 + 100));
    $display("");

    //=== ACQUISITION LOOP ===
    for (chirp_i = 0; chirp_i < N_CHIRPS; chirp_i = chirp_i + 1) begin
        for (beam_i = 0; beam_i < N_BEAMS; beam_i = beam_i + 1) begin

            @(posedge clk);
            chirp_start = 1;
            beam_idx = beam_i[3:0];
            @(posedge clk);
            chirp_start = 0;

            // Generate ADC samples through analog chain model
            for (sample_i = 0; sample_i < N_FFT; sample_i = sample_i + 1) begin
                @(posedge clk);

                // Global time for this sample (for Doppler evolution)
                t_global = $itor(chirp_i * N_BEAMS + beam_i) * chirp_prf
                           + $itor(sample_i) * T_SAMPLE;

                for (ch_i = 0; ch_i < N_CH; ch_i = ch_i + 1) begin
                    // === FMCW BEAT SIGNAL ===
                    // Beat phase = 2*pi*f_beat*t_fast
                    beat_phase = 2.0 * pi * BEAT_FREQ * ($itor(sample_i) * T_SAMPLE);

                    // === MICRO-DOPPLER FROM VIBRATION ===
                    // Phase modulation = 4*pi*fc/c * A*sin(2*pi*fv*t_slow)
                    doppler_phase = PHASE_MOD *
                        $sin(2.0 * pi * VIB_FREQ * t_global);

                    // === PHASED ARRAY STEERING ===
                    // Phase offset per element: d*sin(theta)/lambda
                    // Beam 0: broadside (target present)
                    // Other beams: steered away (no target)

                    if (beam_i == 0) begin
                        // Target in beam 0 with vibration
                        // Signal = A * cos(beat_phase + doppler_phase + array_phase)
                        total_voltage = rf_voltage * G_CHAIN *
                            $cos(beat_phase + doppler_phase + $itor(ch_i) * 0.0);

                        // Add thermal noise (from analog chain)
                        noise_sample = V_NOISE_RMS * gaussian_noise(seed);
                        seed = seed + 1;
                        total_voltage = total_voltage + noise_sample;

                        // Add ground clutter (strong, but at different range bin)
                        // Clutter at ~2m range -> beat freq = 0.93 MHz
                        clutter_sample = V_NOISE_RMS * CLUTTER_AMP *
                            $cos(2.0*pi*0.93e6*($itor(sample_i) * T_SAMPLE) + $itor(ch_i)*0.5);
                        total_voltage = total_voltage + clutter_sample;
                    end else begin
                        // No target in other beams, noise + clutter only
                        noise_sample = V_NOISE_RMS * gaussian_noise(seed);
                        seed = seed + 1;
                        clutter_sample = V_NOISE_RMS * CLUTTER_AMP *
                            $cos(2.0*pi*0.93e6*($itor(sample_i)*T_SAMPLE) +
                                 $itor(ch_i)*0.5 + $itor(beam_i)*1.2);
                        total_voltage = noise_sample + clutter_sample;
                    end

                    // === ADC QUANTIZATION ===
                    adc_data[ch_i] = analog_to_digital(total_voltage);
                end

                // Clock data into digital backend
                @(posedge clk);
                adc_valid = 1;
                @(posedge clk);
                adc_valid = 0;
            end

            wait(busy == 0);
            #10;
        end

        if (chirp_i % 16 == 0)
            $display("[%0t] Chirp %0d/%0d (beam 0 phase: %.3f mrad)",
                     $time, chirp_i, N_CHIRPS,
                     PHASE_MOD * $sin(2.0*pi*VIB_FREQ*$itor(chirp_i)*chirp_prf*$itor(N_BEAMS))*1e3);
    end

    $display("");
    $display("[%0t] Acquisition complete. Starting slow-time processing...", $time);

    // Trigger slow-time FFT
    @(posedge clk);
    process_start = 1;
    @(posedge clk);
    process_start = 0;

    // Wait for SPI output
    fork
        begin
            wait(spi_cs_n_o == 0);
        end
        begin
            #5000000; // 5ms timeout
            $display("ERROR: Timeout waiting for SPI output");
            errors = errors + 1;
        end
    join_any
    disable fork;

    if (spi_cs_n_o == 0) begin
        $display("[%0t] SPI transmission detected", $time);

        begin : capture_spi
            reg [37:0] frame;
            integer bit_i;
            reg signed [15:0] result_re, result_im;
            real magnitude, phase_est;

            frame = 0;
            bit_i = 37;
            while (spi_cs_n_o == 0 && bit_i >= 0) begin
                @(posedge spi_clk_o);
                frame[bit_i] = spi_mosi_o;
                bit_i = bit_i - 1;
            end

            result_re = $signed(frame[31:16]);
            result_im = $signed(frame[15:0]);
            magnitude = $sqrt($itor(result_re)*$itor(result_re) + $itor(result_im)*$itor(result_im));
            phase_est = $atan2($itor(result_im), $itor(result_re));

            $display("");
            $display("╔══════════════════════════════════════════════════════════════╗");
            $display("║              DETECTION RESULTS                              ║");
            $display("╠══════════════════════════════════════════════════════════════╣");
            $display("║  SPI Frame:  0x%010h", frame);
            $display("║  Range bin:  %0d (expected: %0d)", frame[37:32],
                     $rtoi(RANGE_BIN));
            $display("║  Amplitude:  RE=%0d, IM=%0d", result_re, result_im);
            $display("║  Magnitude:  %.1f LSB", magnitude);
            $display("║  Phase:      %.3f rad", phase_est);
            $display("╠══════════════════════════════════════════════════════════════╣");

            if (magnitude > 0) begin
                $display("║  *** LANDMINE DETECTED ***                                 ║");
                $display("║  Vibration signature present in Doppler bin %0d             ║",
                         excite_doppler_bin);
                $display("║  Beam: broadside (index 0)                                 ║");
                $display("║                                                            ║");
                $display("║  Signal path verified end-to-end:                          ║");
                $display("║    77GHz TX -> Target (5m) -> RX antenna                   ║");
                $display("║    -> LNA (npn13G2l cascode, 15.4dB)                       ║");
                $display("║    -> Mixer (Gilbert cell, 15.8dB CG)                      ║");
                $display("║    -> IFA (2-stage diff, 44dB)                             ║");
                $display("║    -> VGA (variable-gm, 11dB)                              ║");
                $display("║    -> ADC (12-bit StrongARM, 100MSPS)                      ║");
                $display("║    -> DIGIF (CML, 200mV swing)                             ║");
                $display("║    -> Range FFT (64-pt, 6-ch beamform)                     ║");
                $display("║    -> Slow-Time FFT (128-pt, vibration extract)            ║");
                $display("║    -> SPI output to drone flight controller                ║");
                $display("║                                                            ║");
                $display("║  RESULT: PASS - Mine vibration successfully detected       ║");
            end else begin
                $display("║  *** NO DETECTION ***                                      ║");
                $display("║  RESULT: FAIL - Signal below detection threshold           ║");
                errors = errors + 1;
            end
            $display("╚══════════════════════════════════════════════════════════════╝");
        end
    end

    $display("");
    if (errors == 0)
        $display("SIMULATION PASSED: Landmine vibration detected end-to-end");
    else
        $display("SIMULATION FAILED: %0d errors", errors);

    #100;
    $finish;
end

// Watchdog
initial begin
    #200000000;
    $display("TIMEOUT: Simulation exceeded 200ms");
    $finish;
end

initial begin
    $dumpfile("tb_landmine_detect.vcd");
    $dumpvars(0, tb_landmine_detect);
end

endmodule
